Timboooh/SmartSensorB4B/Hardware/SmartSensor v1.3 - gerber/BOM SmartSensor.xlsx

Id | Designator | Package | Quantity | Designation | Mouser
1 | U4 | TQFP-44_10x10mm_P0.8mm | 1 | ATmega324PB-AU | ATMEGA324PB-AU (https://nl.mouser.com/ProductDetail/556-ATMEGA324PBAU/)
2 | IC5 | SOT65P210X110-6N | 1 | NUF2221W1T2G | NUF2221W1T2G (https://nl.mouser.com/ProductDetail/onsemi/NUF2221W1T2G?qs=ZXBb0xZ9WeBhigCT%252BMBgKA%3D%3D)
3 | R7 | R_0805_2012Metric | 1 | 10k
4 | C1,C3,C4,C17 | C_0805_2012Metric | 4 | 10uF
5 | C2,C5,C7,C8,C10,C12,C13,C14,C19,C21 | C_0805_2012Metric | 10 | 100nF
6 | C6,C16 | C_0805_2012Metric | 2 | 1uF
7 | C9,C11 | C_0805_2012Metric | 2 | 22pF
8 | C15 | C_0805_2012Metric | 1 | 8.2pF
9 | C18 | CP_Radial_D14.0mm_P5.00mm | 1 | 1F
10 | D1,D2,D5 | D_0805_2012Metric | 3 | D_Small | NSVR1020MW2T1G (https://nl.mouser.com/ProductDetail/ON-Semiconductor/NSVR1020MW2T1G/)
11 | D3, D4 | LED_0805_2012Metric | 1 | RED | 150080SS75000 (https://nl.mouser.com/ProductDetail/Wurth-Elektronik/150080SS75000/?qs=LlUlMxKIyB2zzpiaOzrUdw%3D%3D)
13 | F1 | Fuse_1812_4532Metric | 1 | Polyfuse_Small | 1812L300MR (https://nl.mouser.com/ProductDetail/Littelfuse/1812L300MR/?qs=fp%2Fo%2FcJ74okPZmQQaLnihw%3D%3D)
14 | IC2 | AMS_QFN-4-1EP_2x2mm_P0.95mm_EP0.7x1.6mm | 1 | SHTC3 | SHTC3 (https://nl.mouser.com/ProductDetail/Sensirion/SHTC3/?qs=y6ZabgHbY%252Bx3LlA87fqBwg%3D%3D)
15 | J1 | USB_Micro-B_Amphenol_10103594-0001LF_Horizontal | 1 | USB_B_Micro | 10103594-0001LF (https://nl.mouser.com/ProductDetail/Amphenol-FCI/10103594-0001LF)
16 | J2 | PinHeader_1x02_P2.54mm_Vertical | 1 | BAT_1
17 | J3 | PinHeader_1x02_P2.54mm_Vertical | 1 | BAT_2
18 | J4,J8 | PinHeader_1x06_P2.54mm_Vertical | 2 | Conn_01x06_Male
19 | J5,J6 | PinHeader_2x05_P2.54mm_Vertical | 2 | Conn_02x05_Odd_Even
20 | J7 | PinHeader_1x02_P2.54mm_Vertical | 1 | Conn_01x02_Male
21 | J9 | PinHeader_2x04_P2.54mm_Vertical | 1 | Conn_02x04_Odd_Even
22 | J10 | PinHeader_1x12_P2.54mm_Vertical | 1 | PANTS_1
23 | J11 | PinHeader_1x12_P2.54mm_Vertical | 1 | PANTS_3
24 | J12 | PinHeader_1x12_P2.54mm_Vertical | 1 | PANTS_4
25 | L1 | L_Vishay_IHLP-2020 | 1 | 2.2uH @ 2,5A | IHLP2020CZER2R2M11 (https://nl.mouser.com/ProductDetail/Vishay-Dale/IHLP2020CZER2R2M11/?qs=6luCnr706CzLTrsnHEyf2A%3D%3D)
26 | L2 | L_1206_3216Metric_Pad1.42x1.75mm_HandSolder | 1 | 4.7uH | AIML-1206-4R7K-T (https://nl.mouser.com/ProductDetail/ABRACON/AIML-1206-4R7K-T?qs=1vO2EIVe%252BY78r6VHt%252BJPBQ%3D%3D)
27 | Q1 | SOT-23 | 1 | DMG2301L | DMG2301LK-7 (https://nl.mouser.com/ProductDetail/Diodes-Incorporated/DMG2301LK-7/)
28 | R1,R5 | R_0805_2012Metric | 2 | 100k
29 | R2 | R_0805_2012Metric | 1 | 200k
30 | R3 | R_0805_2012Metric | 1 | 100
31 | R8,R10 | R_0805_2012Metric | 2 | 2.2k
32 | R9,R12,R4 | R_0805_2012Metric | 3 | 330
33 | U1 | Texas_DRC0010J_ThermalVias | 1 | TPS63001 | TPS63001DRCR (https://nl.mouser.com/ProductDetail/Texas-Instruments/TPS63001DRCR/?qs=QZuYiDxzHagn01UZf%2F%252B1Bw%3D%3D)
34 | U2 | AMS_LGA-10-1EP_2.7x4mm_P0.6mm | 1 | CCS811 | CCS811B-JOPR (https://nl.mouser.com/ProductDetail/ScioSense/CCS811B-JOPR/?qs=DPoM0jnrROVuOwd2mTsTQg%3D%3D)
35 | U3 | SOIC-8_3.9x4.9mm_P1.27mm | 1 | MCP7940N-xSN | MCP7940N-I/SN (https://nl.mouser.com/ProductDetail/Microchip-Technology/MCP7940N-I-SN/?qs=o%2FJGMiCJeCOTsMP4nrR5Uw%3D%3D)
36 | Y2 | Crystal_SMD_G8-2Pin_3.2x1.5mm | 1 | Crystal | ABS07W-32.768kHz-K-1-T (https://nl.mouser.com/ProductDetail/ABRACON/ABS07W-32768kHz-K-1-T/?qs=gt1LBUVyoHnktSE7ztRl4g%3D%3D)
37 | IC3 | XB24CAPIT-001 | 1 | XB24CZ7PIT-004 | XB24CAWIT-001 (https://nl.mouser.com/ProductDetail/DIGI/XB24CAWIT-001)
38 | IC4 | SOIC127P600X175-8N | 1 | ATECC608B-SSHDA-B | ATECC608B-SSHDA-B (https://nl.mouser.com/ProductDetail/Microchip-Technology/ATECC608B-SSHDA-B/)
39 | Y1 | Crystal_SMD_Abracon_ABM3-2Pin_5.0x3.2mm | 1 | 20MHz | ABM3AIG-20.000MHZ-8-1R-T (https://nl.mouser.com/ProductDetail/ABRACON/ABM3AIG-20000MHZ-8-1R-T/?qs=uwxL4vQweFPdWRyKGKRehg%3D%3D)
41 | IC1 | VEML7700 | 1 | VEML7700-TT | VEML7700-TT (https://nl.mouser.com/ProductDetail/Vishay-Semiconductors/VEML7700-TT/)
42 | S1,S2,S3 | LL3301FF065QJ | 3 | LL3301FF065QJ | LL3301FF065QJ (https://nl.mouser.com/ProductDetail/E-Switch/LL3301FF065QJ/)
43 | D6 | LED_0805_2012Metric | 1 | GREEN | 150080GS75000 (https://nl.mouser.com/ProductDetail/Wurth-Elektronik/150080GS75000?qs=2kOmHSv6VfQRoTEZVk1mGA%3D%3D)
44 | C20 | C_0805_2012Metric | 1 | 4.7uF | CL21A475KPFNNWE (https://nl.mouser.com/ProductDetail/Samsung-Electro-Mechanics/CL21A475KPFNNWE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)
45 | D7,D8 | D_0805_2012Metric | 2 | B360Q-13-F | https://nl.mouser.com/ProductDetail/Diodes-Incorporated/B360Q-13-F?qs=CfuTe0PnivpjYcJ88%252B2oEQ%3D%3D
48 | R6 | R_0805_2012Metric | 1 | 22,1K
49 | R11 | R_0805_2012Metric | 1 | 47,5K
50 | R13 | R_0805_2012Metric | 1 | 1K
51 | R14 | R_0805_2012Metric | 1 | 100K
52 | U5 | QFN-24-1EP_4x4mm_P0.5mm_EP2.6x2.6mm | 1 | CP2102N-A01-GQFN24 | CP2102N-A02-GQFN24 (https://nl.mouser.com/ProductDetail/Silicon-Labs/CP2102N-A02-GQFN24?qs=u16ybLDytRYKabtL%2FE7DZA%3D%3D)
