Timboooh/SmartSensorB4B/Hardware/SmartSensor.kicad_pcb

## KiCad design Hardware/SmartSensor.kicad_pcb (2022-04-12)

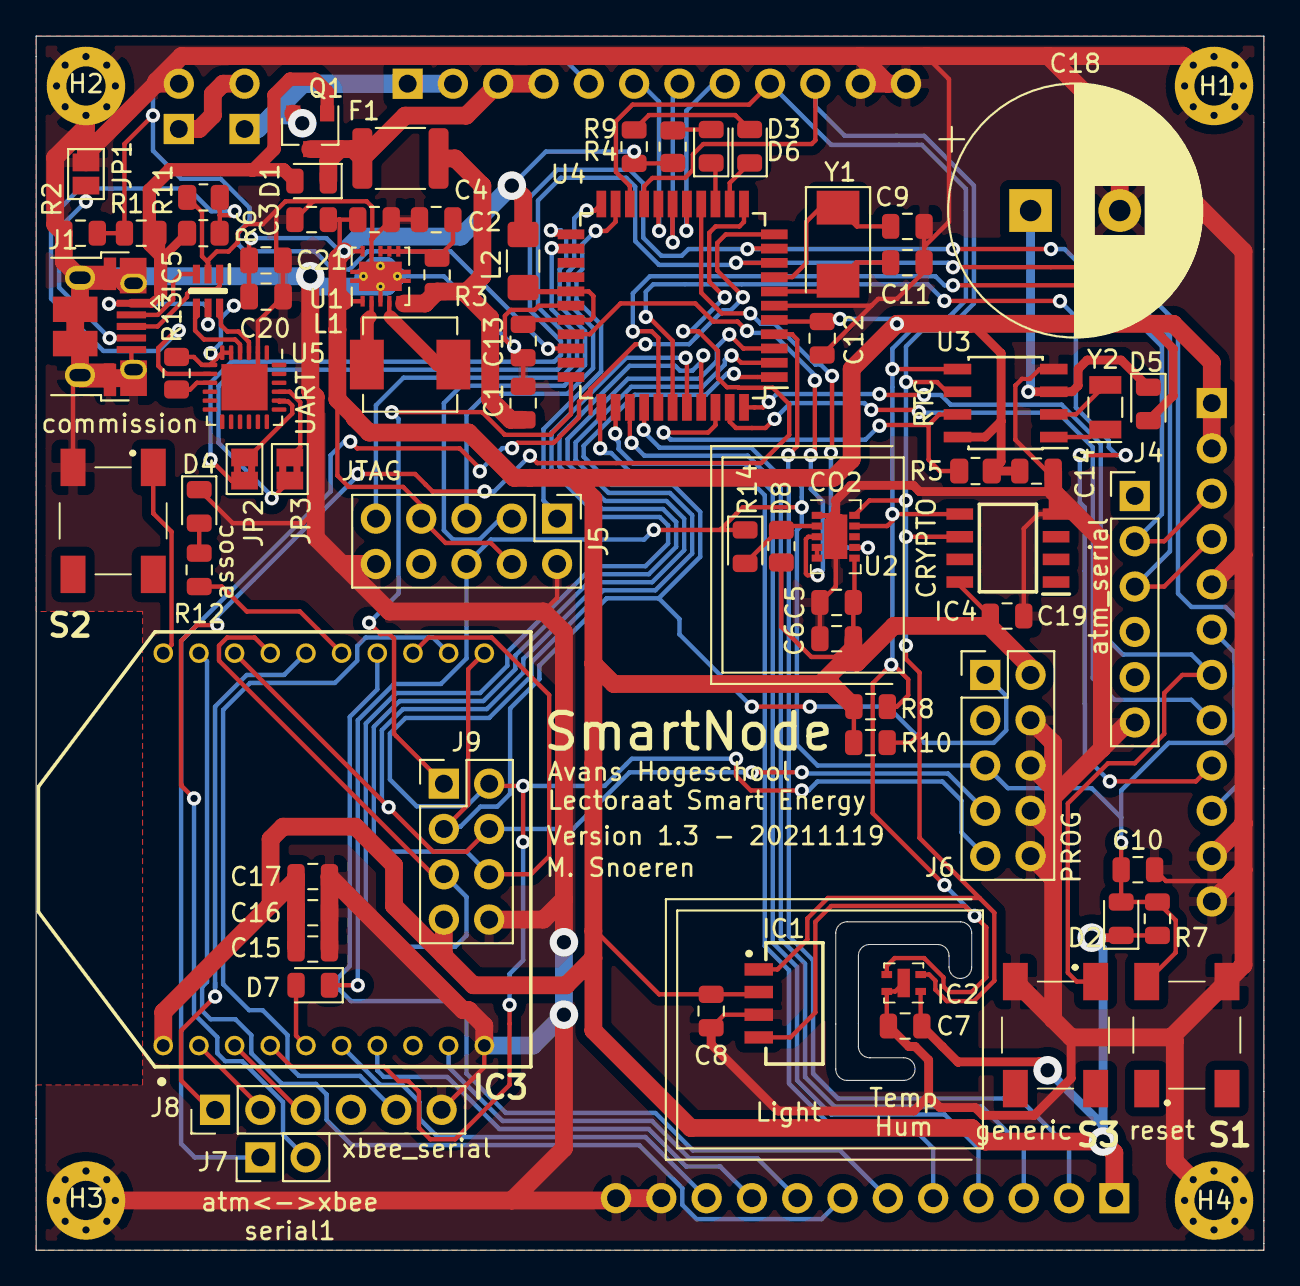
[picture p1: board SmartSensor.kicad_pcb from above]

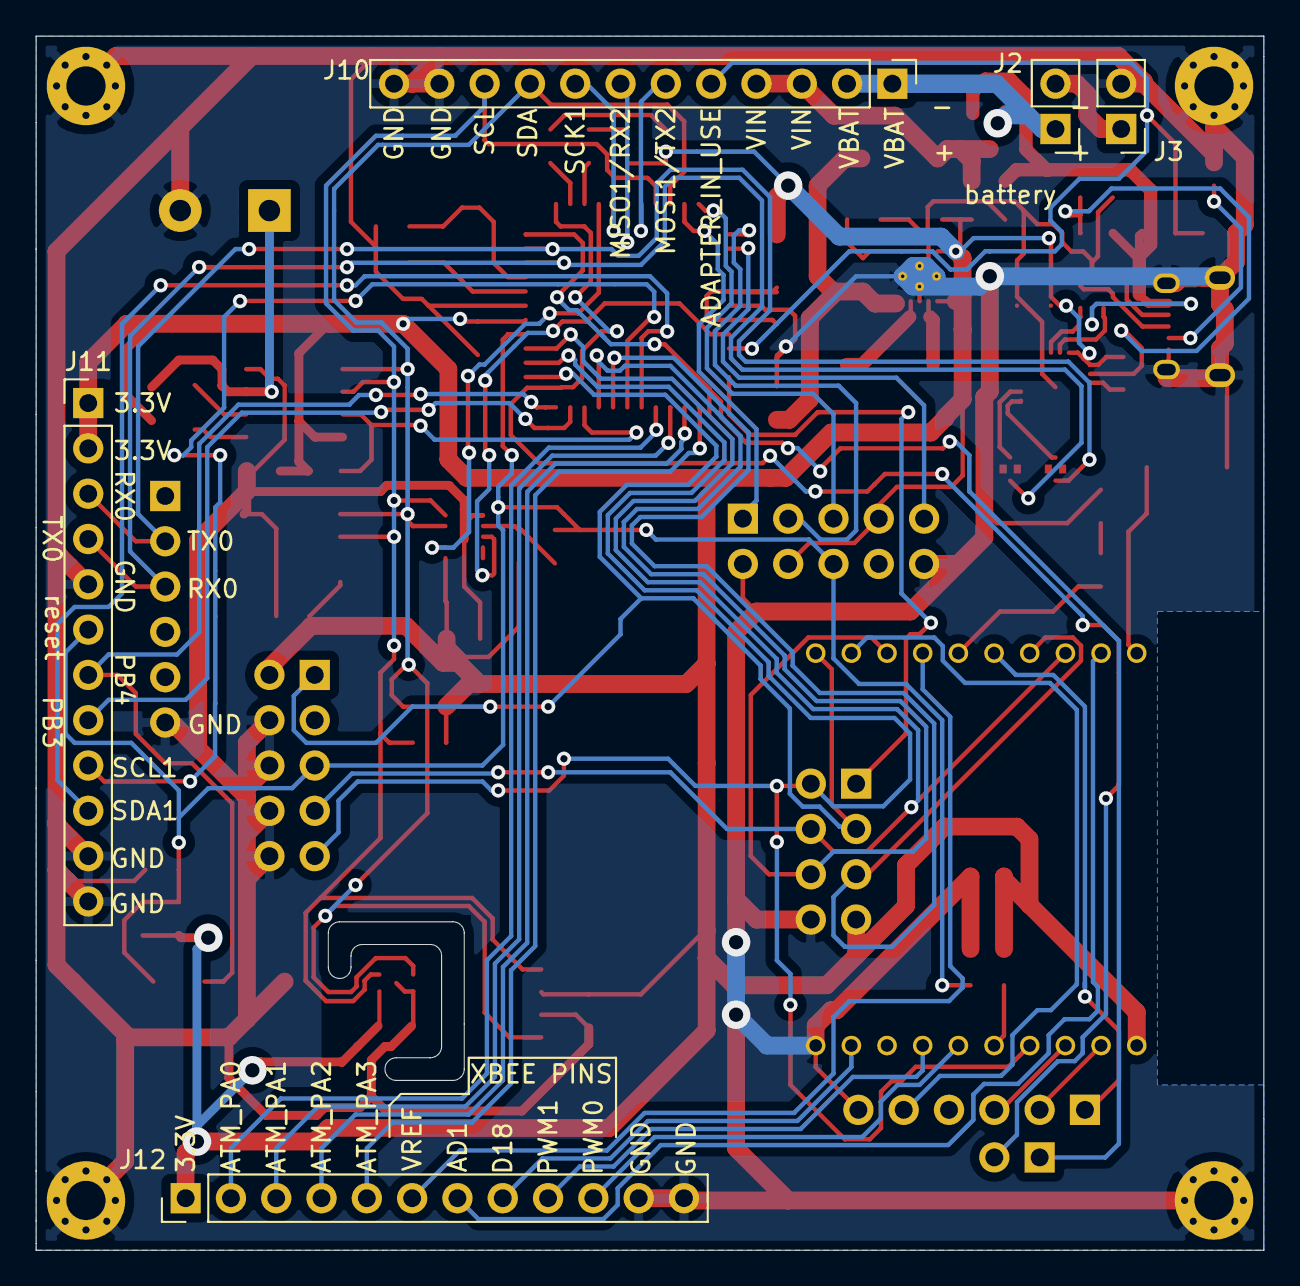
[picture p2: board SmartSensor.kicad_pcb from below]

Board: 2 copper layers, 68.8 x 68.1 mm, 81 parts (5 on the bottom side), 76 nets.

Parts:
C1, C3, C4, C17: 10uF; C_0805_2012Metric
C2, C5, C7, C8, C10, C12, C13, C14, C19, C21: 100nF; C_0805_2012Metric
C6, C16: 1uF; C_0805_2012Metric
C9, C11: 22pF; C_0805_2012Metric
C15: 8.2pF; C_0805_2012Metric
C18: 1F; CP_Radial_D14.0mm_P5.00mm
C20: 4.7uF; C_0805_2012Metric
D1, D2, D5: D_Small; D_0805_2012Metric
D3: RED; LED_0805_2012Metric
D4: ASSOCIATION LED; LED_0805_2012Metric
D6: GREEN; LED_0805_2012Metric
D7, D8: BAT54???; D_0805_2012Metric
F1: Polyfuse_Small; Fuse_1812_4532Metric
H1, H2, H3, H4: MountingHole_Pad; MountingHole_2.2mm_M2_Pad_Via
IC1: VEML7700-TT; VEML7700
IC2: SHTC3; AMS_QFN-4-1EP_2x2mm_P0.95mm_EP0.7x1.6mm
IC3: XB24CZ7PIT-004; XB24CAPIT-001
IC4: ATECC608B-SSHDA-B; SOIC127P600X175-8N
IC5: NUF2221W1T2G; SOT65P210X110-6N
J1: USB_B_Micro; USB_Micro-B_Amphenol_10103594-0001LF_Horizontal
J2: BAT_1; PinHeader_1x02_P2.54mm_Vertical
J3: BAT_2; PinHeader_1x02_P2.54mm_Vertical
J4, J8: Conn_01x06_Male; PinHeader_1x06_P2.54mm_Vertical
J5, J6: Conn_02x05_Odd_Even; PinHeader_2x05_P2.54mm_Vertical
J7: Conn_01x02_Male; PinHeader_1x02_P2.54mm_Vertical
J9: Conn_02x04_Odd_Even; PinHeader_2x04_P2.54mm_Vertical
J10: PANTS_1; PinHeader_1x12_P2.54mm_Vertical
J11: PANTS_3; PinHeader_1x12_P2.54mm_Vertical
J12: PANTS_4; PinHeader_1x12_P2.54mm_Vertical
JP1: ID; SolderJumper-2_P1.3mm_Open_Pad1.0x1.5mm
JP2, JP3: DISABLE; SolderJumper-2_P1.3mm_Bridged2Bar_Pad1.0x1.5mm
L1: 2.2uH @ 2,5A; L_Vishay_IHLP-2020
L2: 4.7uH; L_1206_3216Metric_Pad1.42x1.75mm_HandSolder
Q1: DMG2301L; SOT-23
R1, R5: 100k; R_0805_2012Metric
R2: 200k; R_0805_2012Metric
R3: 100; R_0805_2012Metric
R4, R9, R12: 330; R_0805_2012Metric
R6: 22,1K; R_0805_2012Metric
R7: 10k; R_0805_2012Metric
R8, R10: 2.2k; R_0805_2012Metric
R11: 47,5K; R_0805_2012Metric
R13: 1K; R_0805_2012Metric
R14: 100K; R_0805_2012Metric
S1, S2, S3: LL3301FF065QJ
U1: TPS63001; Texas_DRC0010J_ThermalVias
U2: CCS811; AMS_LGA-10-1EP_2.7x4mm_P0.6mm
U3: MCP7940N-xSN; SOIC-8_3.9x4.9mm_P1.27mm
U4: ATmega324PB-AU; TQFP-44_10x10mm_P0.8mm
U5: CP2102N-A01-GQFN24; QFN-24-1EP_4x4mm_P0.5mm_EP2.6x2.6mm
Y1: 20MHz; Crystal_SMD_Abracon_ABM3-2Pin_5.0x3.2mm
Y2: Crystal; Crystal_SMD_G8-2Pin_3.2x1.5mm

Connections:
+3V3: C3.1, C4.1, C5.1, C6.1, C7.1, C8.1, C12.1, C14.1, C15.1, C16.1, C17.1, C19.1, C20.1, C21.1, D2.1, D5.2, IC1.2, IC2.1, IC3.1, IC4.8, J5.4, J5.7, J6.2, J9.7, J11.1, J11.2, J12.1, L2.1, R4.2, R5.1, R7.1, R8.1, R9.2, R10.1, R13.2, R14.1, U1.1, U1.10, U2.6, U3.8, U4.5, U5.5, U5.6, U5.7
/Communication/RF_IRQ: J9.1, U4.33
/Interface/ADAPTER_IN_USE: J10.5, R1.1, R2.2, U4.31
/Interface/ATM_MISO_1_RXD_2: J10.7, U4.17
/Interface/ATM_MOSI_1_TXD_2: J10.6, U4.18
/Interface/ATM_PA0: J12.2, U4.37
/Interface/ATM_PA1: J12.3, U4.36
/Interface/ATM_PA2: J12.4, U4.35
/Interface/ATM_PA3: J12.5, U4.34
/Interface/ATM_PB3: J11.8, U4.43
/Interface/ATM_PB4: J11.7, S3.1, U4.44
/Interface/ATM_SCK_1: J10.8, U4.16
/Interface/ATM_SCL_1: J11.9, U4.39
/Interface/ATM_SDA_1: J11.10, U4.38
/Interface/V_BAT: J2.1, J10.1, J10.2, Q1.2
ATM_AREF: C13.1, L2.2, U4.27, U4.29
ATM_JTAG_TCK: J5.1, U4.21
ATM_JTAG_TDI: J5.9, U4.24
ATM_JTAG_TDO: J5.3, U4.23
ATM_JTAG_TMS: J5.5, U4.22
ATM_MISO: IC3.4, J6.9, J9.2, U4.2
ATM_MOSI: IC3.11, J6.1, J9.3, U4.1
ATM_RESET: C10.1, D2.2, D7.1, D8.1, J5.6, J6.5, J11.6, R7.2, S1.2, U4.4
ATM_RXD_0: J4.3, J11.4, JP3.2, U4.9
ATM_RXD_1: J7.1, U4.11
ATM_SCK: IC3.18, J6.7, J9.4, U4.3
ATM_TXD_0: J4.2, J11.3, JP2.2, U4.10
ATM_TXD_1: J7.2, U4.12
CO2_INT: U2.3, U4.30
CO2_WAKE: U2.7, U4.15
FROM_XBEE_UART_RX: IC3.3, J8.3
FROM_XBEE_UART_TX: IC3.2, J8.2
GND: C1.2, C2.2, C3.2, C4.2, C5.2, C6.2, C7.2, C8.2, C9.2, C10.2, C11.2, C12.2, C13.2, C14.2, C15.2, C16.2, C17.2, C18.2, C19.2, C20.2, C21.2, D4.1, H1.1, H2.1, H3.1, H4.1, IC1.3, IC2.4, IC2.5, IC3.10, IC4.4, IC5.2, J1.5, J1.6, J3.2, J4.6, J5.2, J5.10, J6.4, J6.6, J6.8, J6.10, J8.6, J9.8, J10.11, J10.12, J11.5, J11.11, J11.12, J12.11, J12.12, JP1.2, R2.1, R11.1, S1.4, S2.3, S3.3, U1.3, U1.9, U1.11, U2.1, U2.11, U3.4, U4.6, U4.28, U5.2, U5.25
LED_1: D3.1, U4.13
LED_2: D6.1, U4.14
unnamed: C1.1, F1.1, R3.2, U1.5
unnamed: C2.1, R3.1, U1.6, U1.7, U1.8
unnamed: C9.1, U4.8, Y1.1
unnamed: C11.1, U4.7, Y1.2
unnamed: C18.1, D5.1, U3.3
unnamed: D3.2, R9.1
unnamed: D4.2, R12.1
unnamed: D6.2, R4.1
unnamed: D7.2, IC3.5
unnamed: D8.2, R14.2, U2.2
unnamed: IC3.15, R12.2
unnamed: IC3.20, S2.1
unnamed: IC5.4, U5.4
unnamed: IC5.6, U5.3
unnamed: J1.4, JP1.1
unnamed: J2.2, J3.1
unnamed: JP2.1, U5.20
unnamed: JP3.1, U5.21
unnamed: L1.1, U1.4
unnamed: L1.2, U1.2
unnamed: R6.1, R11.2, U5.8
unnamed: R13.1, U5.9
unnamed: U2.4, U2.5
unnamed: U3.1, Y2.1
unnamed: U3.2, Y2.2
RTC_MFP: R5.2, U3.7, U4.42
SCL: IC1.1, IC2.2, IC4.6, J10.10, R10.2, U2.10, U3.6, U4.19
SDA: IC1.4, IC2.3, IC4.5, J10.9, R8.2, U2.9, U3.5, U4.20
USB_D+: IC5.1, J1.3
USB_D-: IC5.3, J1.2
V_IN: D1.1, F1.2, J10.3, J10.4, Q1.3
V_USB: D1.2, IC5.5, J1.1, Q1.1, R1.2, R6.2
XBEE_AD1: IC3.19, J12.7
XBEE_D18: IC3.9, J12.8
XBEE_PWM0: IC3.6, J12.10
XBEE_PWM1: IC3.7, J12.9
XBEE_SLEEP: IC3.13, J9.6, U4.41
XBEE_SPI_SSEL: IC3.17, J9.5, U4.40
XBEE_UART_CTS: IC3.12, J8.5
XBEE_UART_RTS: IC3.16, J8.1
XBEE_VREF: IC3.14, J12.6
