Timboooh/SmartSensorB4B/(commit log)

2022-04-12 Update kicad files
    [SmartSensor.kicad_sch, SmartSensor.sch, SmartSensor_Communication.kicad_sch, SmartSensor_Communication.sch, SmartSensor_Interface.kicad_sch, SmartSensor_Interface.sch, SmartSensor_MainController.kicad_sch, SmartSensor_MainController.sch]
2022-04-12 Add custom sensor boards
    [B4B.kicad_pcb, B4B.kicad_sch, BOM SmartSensor.xlsx, BOM-SMSENSV1_3.xlsx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]
2022-05-24 removed wrong xbee stuff
    [Board.cpp]
2022-05-24 added xbee driver reference to analog driver
2022-06-07 tried using array, does not work yet
    [Board.cpp, XBeeProS2C.h]
